JacobFEide/Bikube-Bachelor/README.md

# Bikube-Bachelor
Dette er ett samlested for dokumenter, programkode og filer som ble brukt for å fullføre og sette opp vår Bikubemonitorering Bachelor. 
Prosjektet ble utarbeidet og satte opp av Jacob Eide, Erlend Matre og Erling Tellnes.
