JacobFEide/Bikube-Bachelor/dokumenter/Bikubemidveispresentasjon.pptx

## Forside

## Oppgaven vi fikk

Oppgavebeskrivelse
Utvikling av en elektronisk vekt for bikuber som også måler temperatur inni bikuben. Systemet skal:
- Stå permanent under bikuben (utendørs)
- Måle vekt og temperatur kontinuerlig
- Vise sanntidsdata på et display eller via Bluetooth til en smarttelefon
- Lagre data for visning som kurver over tid
- Være en kostnadseffektiv løsning
- Ikke basere seg på Wi-Fi grunnet dårlig mobildekning

## Hvordan vi valgte å tolke oppgaven(Erlend)

## Hvordan vi valgte å løse oppgaven(Erlend)

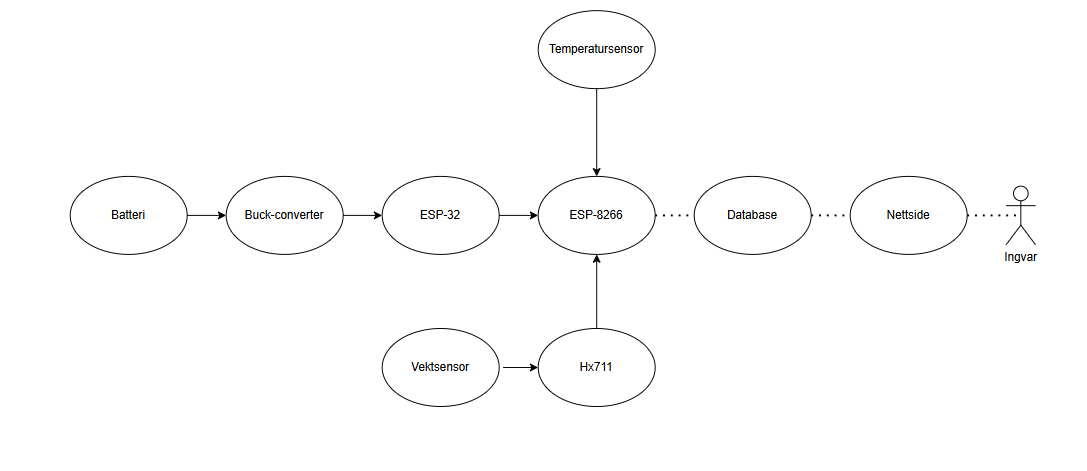
[picture p3: figure]

## Batteri og buck (erling)

-Batteri på 12V, 7.2aH
-Konverterer spenning til 5V
-Bruker 1,5mm^2 ledning

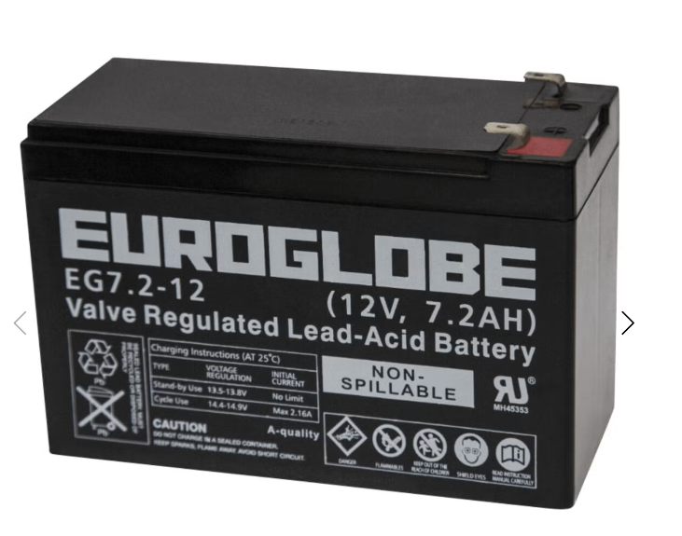
[picture p4: figure]
Et bilde som inneholder batteri, elektronikk, tekst Innhold generert av kunstig intelligens kan være feil.
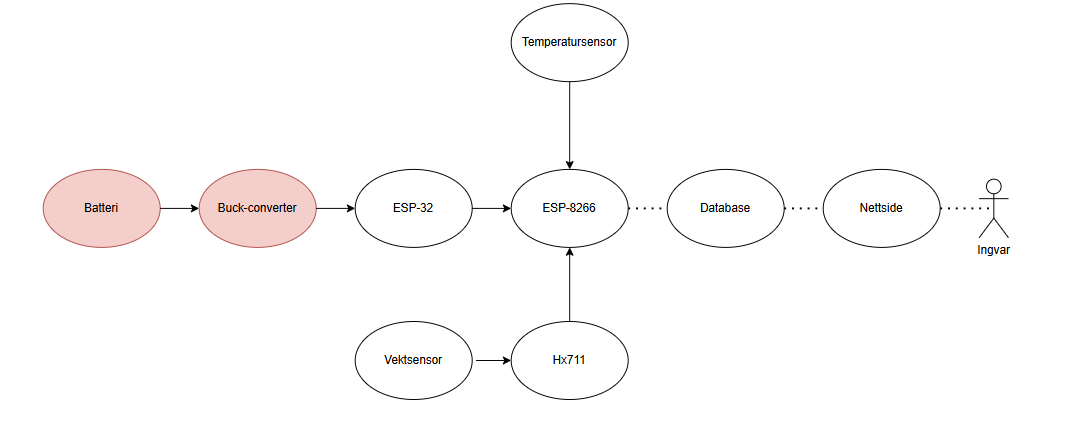
[picture p5: figure]
Et bilde som inneholder tekst, diagram, sirkel Innhold generert av kunstig intelligens kan være feil.
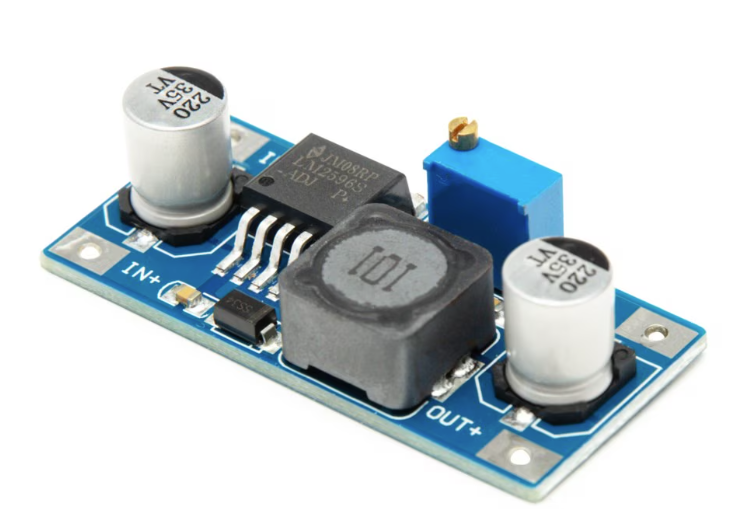
[picture p6: figure]
Et bilde som inneholder elektronikk, kretskomponent, Elektronteknikk, Passiv kretskomponent Innhold generert av kunstig intelligens kan være feil.

## Temperatursensor (erling)

- DS18B20
- Kan måle fra -55 °C til +125 °C
- Digital utgang

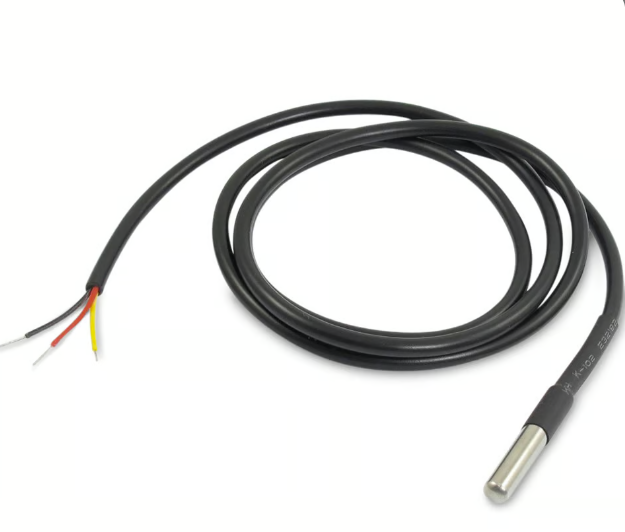
[picture p7: figure]
Et bilde som inneholder kabel, Elektrisk kobling, kobling Innhold generert av kunstig intelligens kan være feil.
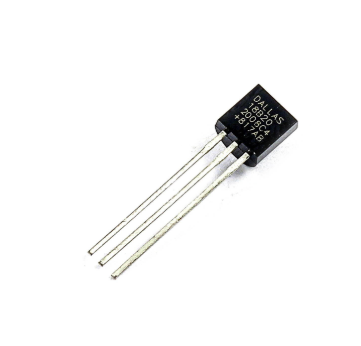
[picture p8: figure]
Et bilde som inneholder elektronikk, kretskomponent, Passiv kretskomponent, Elektronteknikk Innhold generert av kunstig intelligens kan være feil.
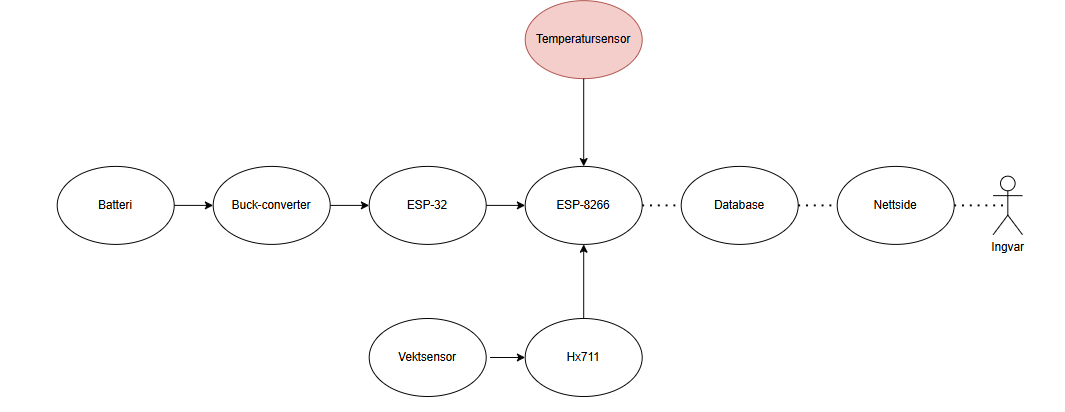
[picture p9: figure]
Et bilde som inneholder tekst, diagram, sirkel, Font Innhold generert av kunstig intelligens kan være feil.

## Vektsensor (erling)

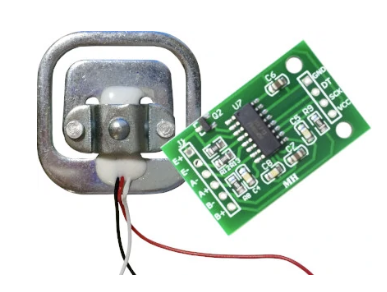
[picture p10: figure]
Et bilde som inneholder Elektronteknikk, kretskomponent, Elektronisk komponent, elektronikk Innhold generert av kunstig intelligens kan være feil.
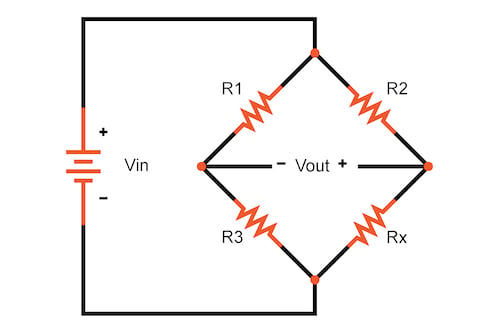
[picture p11: figure]
Example of a Wheatstone bridge circuit

- 4 x YZC-161B
- Koblet som en målebro med strekklapper
- Spenningen forsterkes og digitaliseres med en HX711

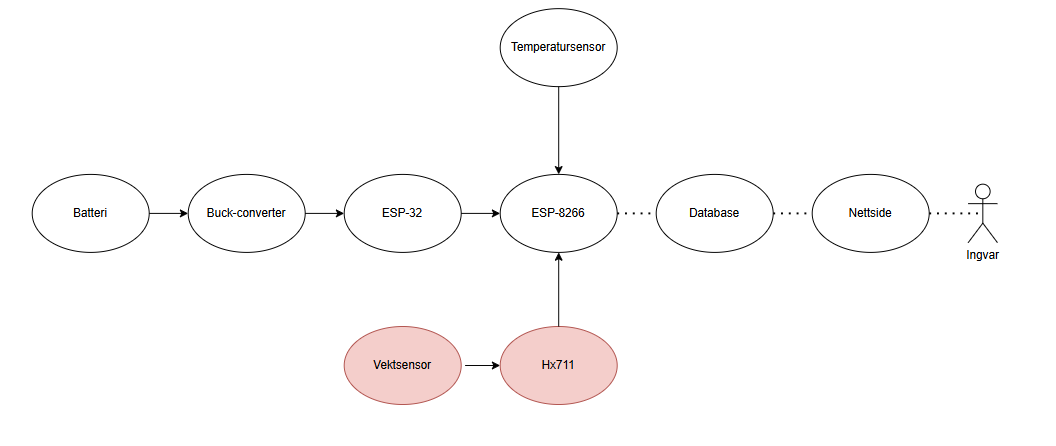
[picture p12: figure]
Et bilde som inneholder diagram, sirkel, tekst Innhold generert av kunstig intelligens kan være feil.

## Mikrokontrollere(Erlend/)

- ESP32 med GSM-modul(A7670E)
- ESP8266

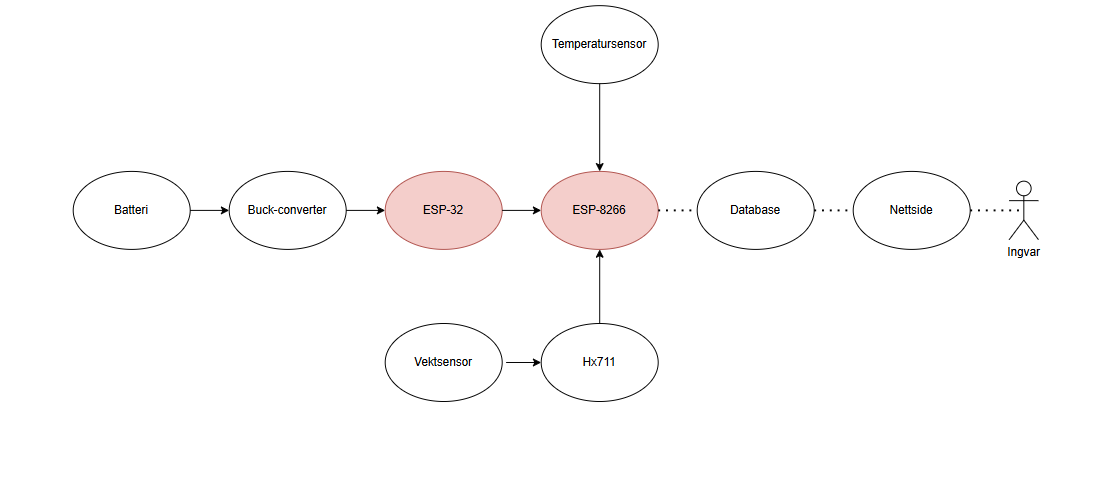
[picture p13: figure]
Et bilde som inneholder diagram, tekst, tegning, sirkel Innhold generert av kunstig intelligens kan være feil.

## Sending av data

Database
Nettside

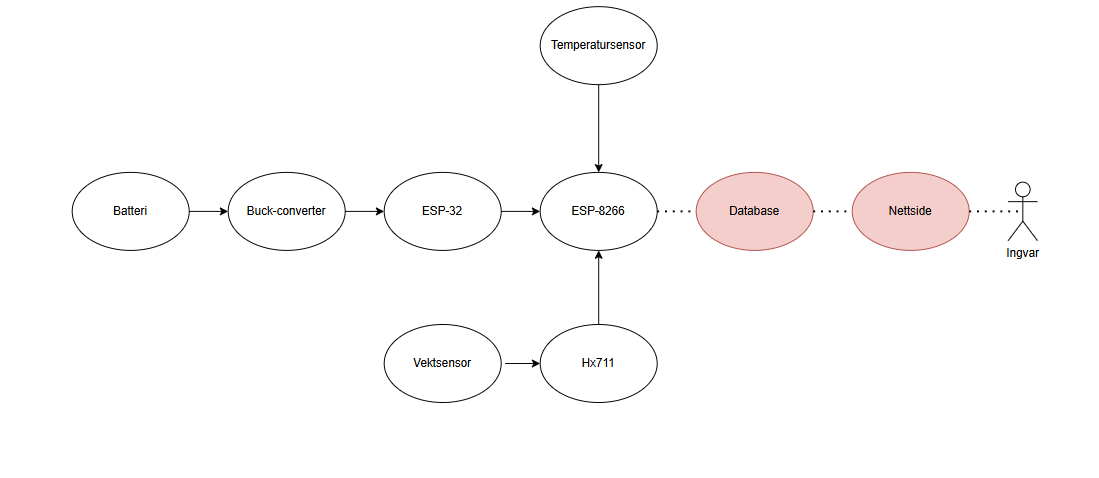
[picture p14: figure]
Et bilde som inneholder tekst, diagram, sirkel Innhold generert av kunstig intelligens kan være feil.

## Visning av video (felles)

## Visning av nettside

## Takk for oss
