JacobFEide/Bikube-Bachelor/dokumenter/PCB_PCB_bikube-kretskort_2_2025-05-19.png

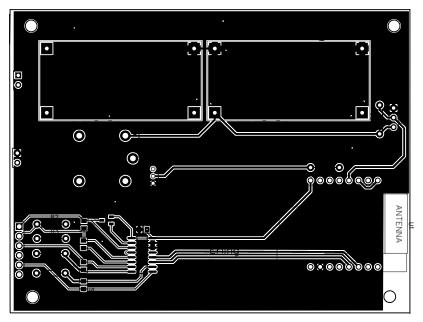
dokumenter/PCB_PCB_bikube-kretskort_2_2025-05-19.png
