JacobFEide/Bikube-Bachelor/Filer til bruksanvisning/BOM_bikube-kretskort_2025-05-16.csv

ID | Name | Designator | Footprint | Quantity
1 | 4.7k | R6 | R_AXIAL-0.3 | 1
2 | 8.2k | R2 | R_AXIAL-0.3 | 1
3 | 20k | R3 | R_AXIAL-0.3 | 1
4 | 1.2k | R4,R5 | R_AXIAL-0.3 | 2
5 | 0.1uF | C4,C5,C8 | 0805 | 3
6 | 10uF | C6,C7 | 0805 | 2
7 | 1k | R1 | R_AXIAL-0.3 | 1
8 | LM2596DC-DC | 5V_TIL_ESP8266,5V_TIL_RSBPIE | LM2596 DC-DC | 2
9 | Inn UT til Pie | H1 | HDR-F-2.54_1X2 | 1
10 | Inn UT Bat | H2 | HDR-F-2.54_1X2 | 1
11 | DS18b20 innganger | H3 | HDR-F-2.54_1X3 | 1
12 | Header-Female-2.54_1x6 | P1 | HDR-6X1/2.54 | 1
13 | 2N7000 | Q1 | 2N7000 | 1
14 | S9015 | Q2 | SOT-23(SOT-23-3) | 1
15 | 5V-12V | RLY1 | RELAY-TH_SRD-XXVDC-XL-C | 1
16 | WEMOS_D1_MINI_PRO4 | U1 | DIP-16_WEMOS_D1_MINI_PRO4 | 1
17 | HX711 | U7 | SOP-16_150MIL | 1
18 | 1N4007W | D1 | SOD-123_L2.8-W1.8-LS3.7-RD | 1
