JacobFEide/Bikube-Bachelor/(list of files, drawings)

Other design files:
Filer til bruksanvisning/PCB_PCB_bikube-kretskort_2_2025-05-16.json
